CU-Rocketry/ground-station/README.md

# ground-station
Ground station for use with CUR SRAD flight computer with telemetry and user interface capabilities
