CU-Rocketry/ground-station/CUR_ground_station_25-26/CUR_ground_station_25-26.kicad_pcb

## KiCad design CUR_ground_station_25-26/CUR_ground_station_25-26.kicad_pcb (2026-04-16)

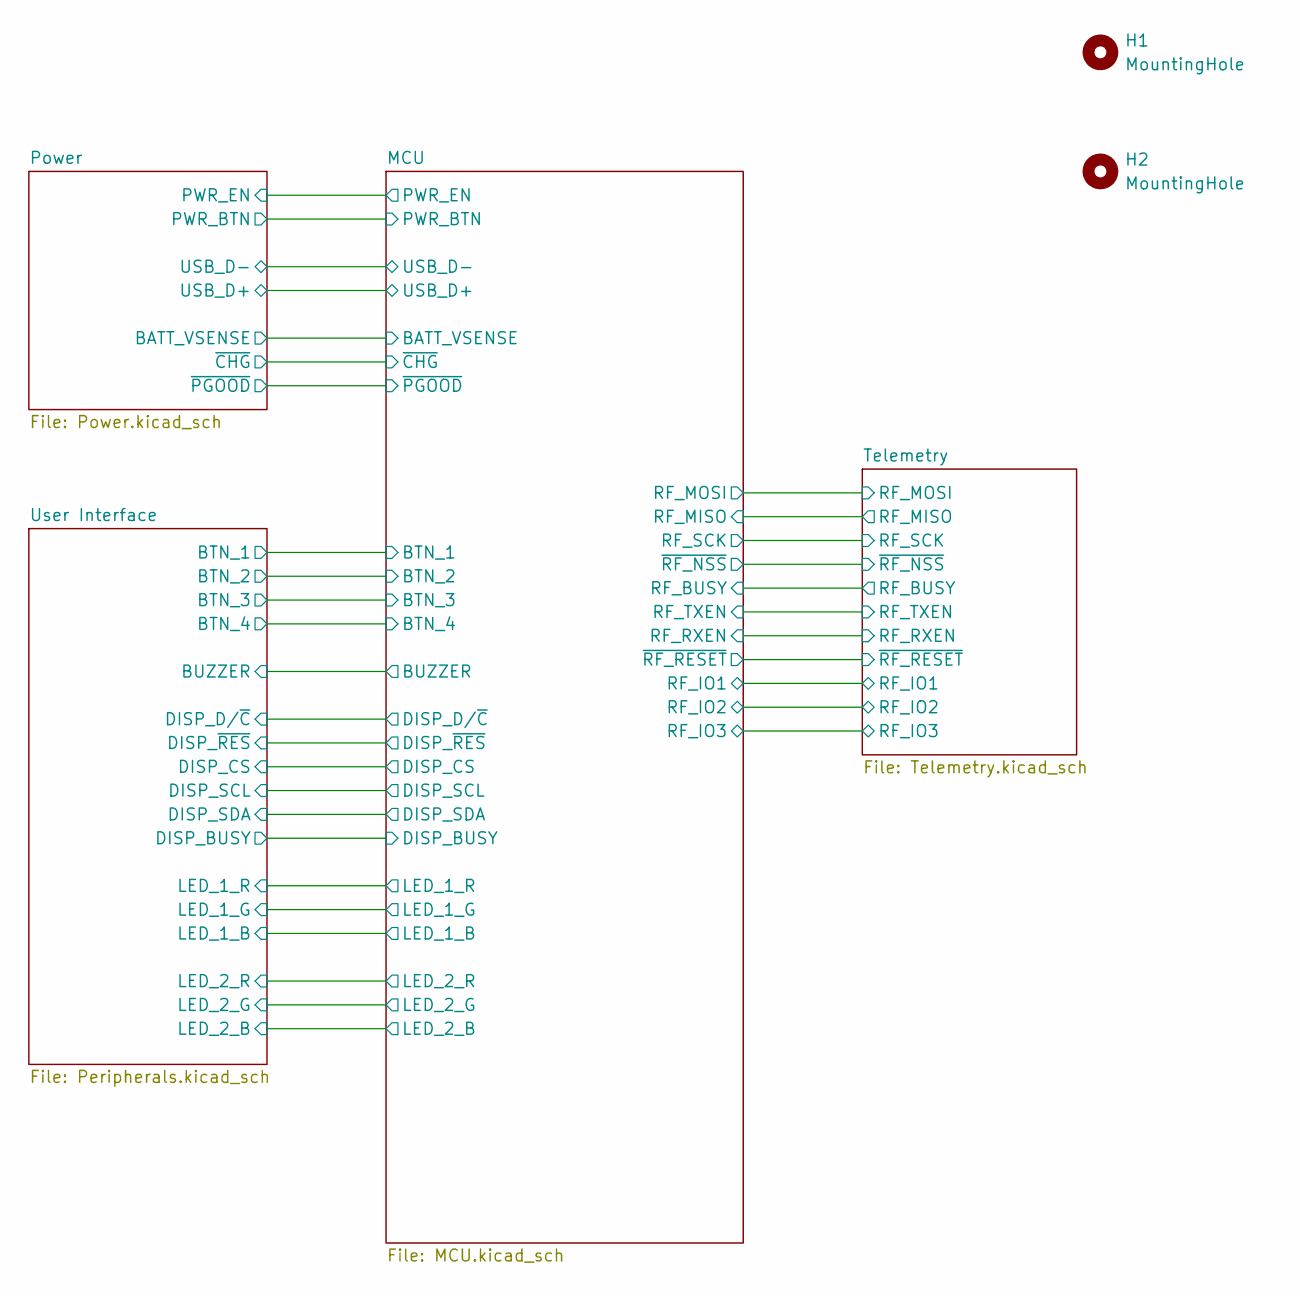
[picture p6: schematic CUR_ground_station_25-26.kicad_sch]

Parts:
H1, H2: MountingHole; MountingHole_3.2mm_M3

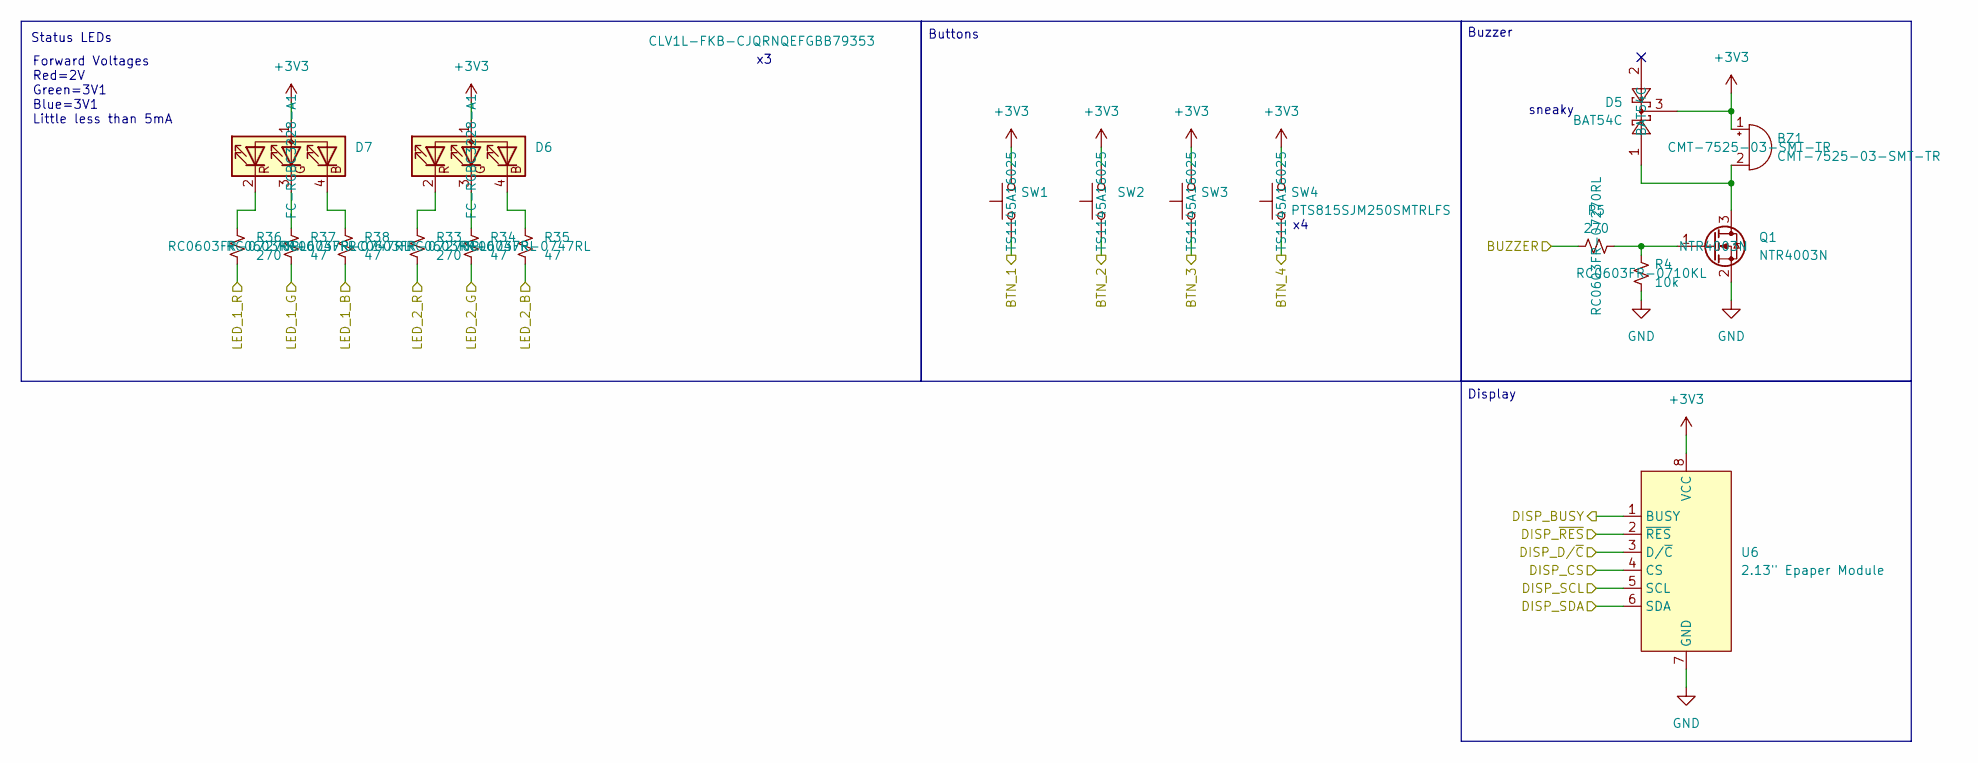
[picture p7: schematic Peripherals.kicad_sch]

Parts:
BZ1: CMT-7525-03-SMT-TR; XDCR_CMT-7525-03-SMT-TR; MPN CMT-7525-03-SMT-TR
D5: BAT54C; SOT-23; MPN BAT54C
D6, D7: CLV1L-FKB-CJQRNQEFGBB79353; LED_Cree-PLCC4_3.2x2.8mm_CCW; MPN FC-RGBC3228-A1
Q1: NTR4003N; SOT-23; MPN NTR4003N
R4: 10k; R_0603_1608Metric; MPN RC0603FR-0710KL
R5, R33, R36: 270; R_0603_1608Metric; MPN RC0603FR-07270RL
R34, R35, R37, R38: 47; R_0603_1608Metric; MPN RC0603FR-0747RL
SW1, SW2, SW3, SW4: PTS815SJM250SMTRLFS; SW_Push_PTS815_SJM_250_SMTR_LFS; MPN TS1145A16025
U6: 2.13" Epaper Module; WeAct-Studio-2.13-Epaper

Connections:
+3V3: BZ1.1 (+), D5.3, D6.1 (A), D7.1 (A), SW1.2, SW2.2, SW3.2, SW4.2, U6.8 (VCC); also elsewhere on the board
/MCU/BTN_1: SW1.1; also elsewhere on the board
/MCU/BTN_2: SW2.1; also elsewhere on the board
/MCU/BTN_3: SW3.1; also elsewhere on the board
/MCU/BTN_4: SW4.1; also elsewhere on the board
/MCU/BUZZER: R5.1; also elsewhere on the board
/MCU/DISP_BUSY: U6.1 (BUSY); also elsewhere on the board
/MCU/DISP_CS: U6.4 (CS); also elsewhere on the board
/MCU/DISP_D/~C: U6.3 (D/~C); also elsewhere on the board
/MCU/DISP_SCL: U6.5 (SCL); also elsewhere on the board
/MCU/DISP_SDA: U6.6 (SDA); also elsewhere on the board
/MCU/DISP_~RES: U6.2 (~RES); also elsewhere on the board
/MCU/LED_1_B: R38.2; also elsewhere on the board
/MCU/LED_1_G: R37.2; also elsewhere on the board
/MCU/LED_1_R: R36.2; also elsewhere on the board
/MCU/LED_2_B: R35.2; also elsewhere on the board
/MCU/LED_2_G: R34.2; also elsewhere on the board
/MCU/LED_2_R: R33.2; also elsewhere on the board
GND: Q1.2 (S), R4.2, U6.7 (GND); also elsewhere on the board
unnamed: BZ1.2 (-), D5.1, Q1.3 (D)
unnamed: D6.4 (BK), R35.1
unnamed: D6.3 (GK), R34.1
unnamed: D6.2 (RK), R33.1
unnamed: D7.4 (BK), R38.1
unnamed: D7.3 (GK), R37.1
unnamed: D7.2 (RK), R36.1
unnamed: Q1.1 (G), R4.1, R5.2

Notes on the sheet:
Forward Voltages Red=2V Green=3V1 Blue=3V1 Little less than 5mA
Buzzer
Buttons
sneaky
Display
Status LEDs

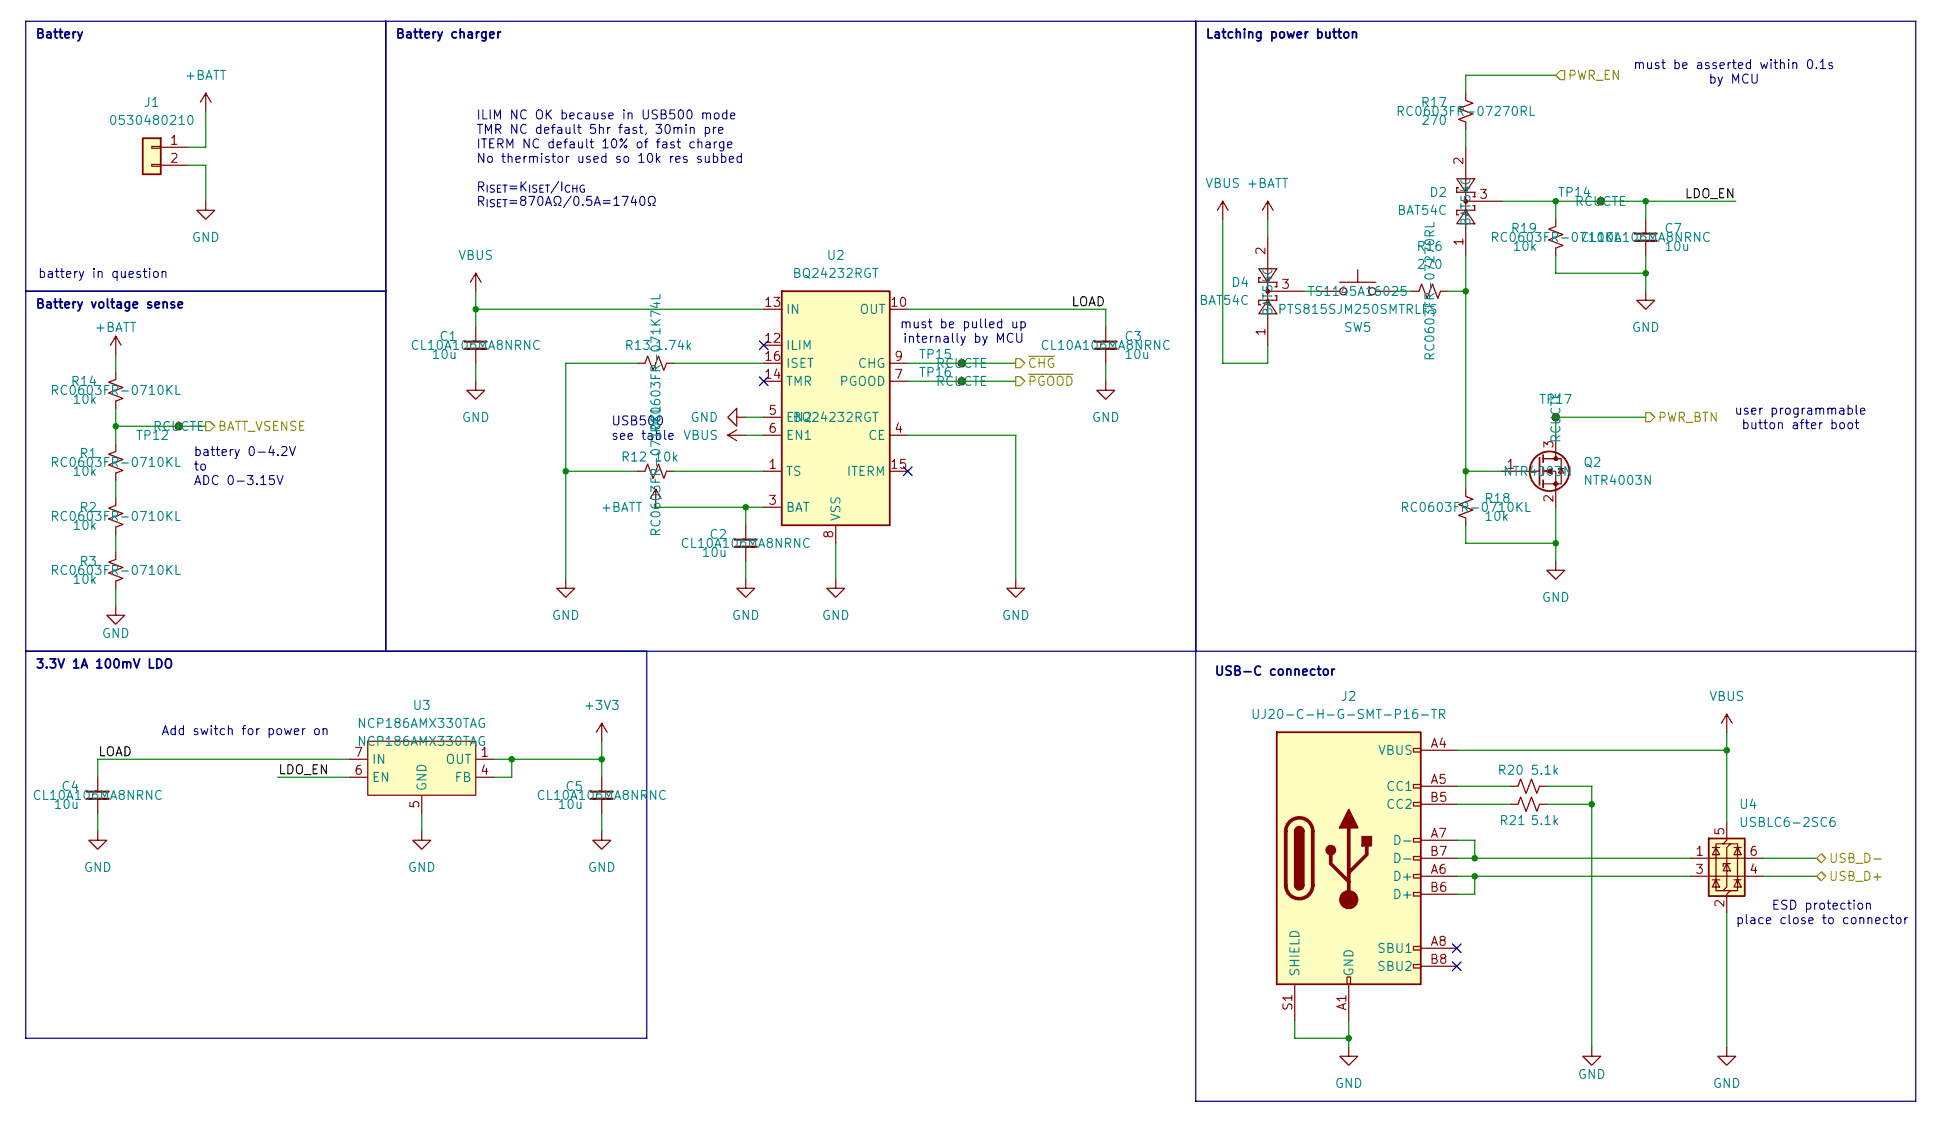
[picture p8: schematic Power.kicad_sch]

Parts:
C1, C2, C3, C4, C5, C7: 10u; C_0603_1608Metric; MPN CL10A106MA8NRNC
D2, D4: BAT54C; SOT-23; MPN BAT54C
J1: 0530480210; Molex_PicoBlade_53048-0210_1x02_P1.25mm_Horizontal; MPN 1.25-2AW
J2: UJ20-C-H-G-SMT-P16-TR; SAMESKY_UJ20-C-H-G-SMT-P16-TR; MPN UJ20-C-H-G-SMT-P16-TR
Q2: NTR4003N; SOT-23; MPN NTR4003N
R1, R2, R3, R12, R14, R18, R19: 10k; R_0603_1608Metric; MPN RC0603FR-0710KL
R13: 1.74k; R_0603_1608Metric; MPN RC0603FR-071K74L
R16, R17: 270; R_0603_1608Metric; MPN RC0603FR-07270RL
R20, R21: 5.1k; R_0603_1608Metric; MPN RC0603FR-075K1L
SW5: PTS815SJM250SMTRLFS; SW_Push_PTS815_SJM_250_SMTR_LFS; MPN TS1145A16025
TP12, TP14, TP15, TP16, TP17: TestPoint_Small; TestPoint_Chip_RCUCTE_0603; MPN RCUCTE
U2: BQ24232RGT; VQFN-16-1EP_3x3mm_P0.5mm_EP1.68x1.68mm; MPN BQ24232RGT
U3: NCP186AMX330TAG; NCP186_XDFN8_1.6x1.2mm_P0.4mm; MPN NCP186AMX330TAG
U4: USBLC6-2SC6; SOT-23-6; MPN USBLC6-2SC6

Connections:
+3V3: C5.1, U3.1 (OUT), U3.2 (OUT), U3.4 (FB); also elsewhere on the board
+BATT: C2.1, D4.2, J1.1, R14.1, U2.2 (BAT), U2.3 (BAT)
/MCU/BATT_VSENSE: R1.1, R14.2, TP12.1; also elsewhere on the board
/MCU/PWR_BTN: Q2.3 (D), TP17.1; also elsewhere on the board
/MCU/PWR_EN: R17.1; also elsewhere on the board
/MCU/USB_D+: U4.4 (I/O2); also elsewhere on the board
/MCU/USB_D-: U4.6 (I/O1); also elsewhere on the board
/MCU/~CHG: TP15.1, U2.9 (CHG); also elsewhere on the board
/MCU/~PGOOD: TP16.1, U2.7 (PGOOD); also elsewhere on the board
/Power/LDO_EN: C7.1, D2.3, R19.1, TP14.1, U3.6 (EN)
GND: C1.2, C2.2, C3.2, C4.2, C5.2, C7.2, J1.2, J2.A1 (GND), J2.A12 (GND), J2.B1 (GND), J2.B12 (GND), J2.S1 (SHIELD), Q2.2 (S), R3.2, R12.1, R13.1, R18.2, R19.2, R20.2, R21.2, U2.4 (CE), U2.5 (EN2), U2.8 (VSS), U2.17 (VSS), U3.3 (N/C), U3.5 (GND), U3.9 (EPAD), U4.2 (GND); also elsewhere on the board
IN: C3.1, C4.1, U2.10 (OUT), U2.11 (OUT), U3.7 (IN), U3.8 (IN)
unnamed: D2.2, R17.2
unnamed: D4.3, SW5.1
unnamed: J2.A5 (CC1), R20.1
unnamed: J2.B5 (CC2), R21.1
unnamed: J2.A6 (D+), J2.B6 (D+), U4.3 (I/O2)
unnamed: J2.A7 (D-), J2.B7 (D-), U4.1 (I/O1)
unnamed: D2.1, Q2.1 (G), R16.2, R18.1
unnamed: R1.2, R2.1
unnamed: R2.2, R3.1
unnamed: R16.1, SW5.2
unnamed: R13.2, U2.16 (ISET)
unnamed: R12.2, U2.1 (TS)
VBUS: C1.1, D4.1, J2.A4 (VBUS), J2.A9 (VBUS), J2.B4 (VBUS), J2.B9 (VBUS), U2.6 (EN1), U2.13 (IN), U4.5 (VBUS)

Notes on the sheet:
R_{ISET}=K_{ISET}/I_{CHG} R_{ISET}=870AΩ/0.5A=1740Ω
must be asserted within 0.1s by MCU
3.3V 1A 100mV LDO
Battery voltage sense
USB-C connector
ILIM NC OK because in USB500 mode TMR NC default 5hr fast, 30min pre ITERM NC default 10% of fast charge No thermistor used so 10k res subbed
Battery
USB500 see table
Latching power button
Add switch for power on
battery 0-4.2V to ADC 0-3.15V
Battery charger
ESD protection place close to connector
must be pulled up internally by MCU
user programmable button after boot
battery in question

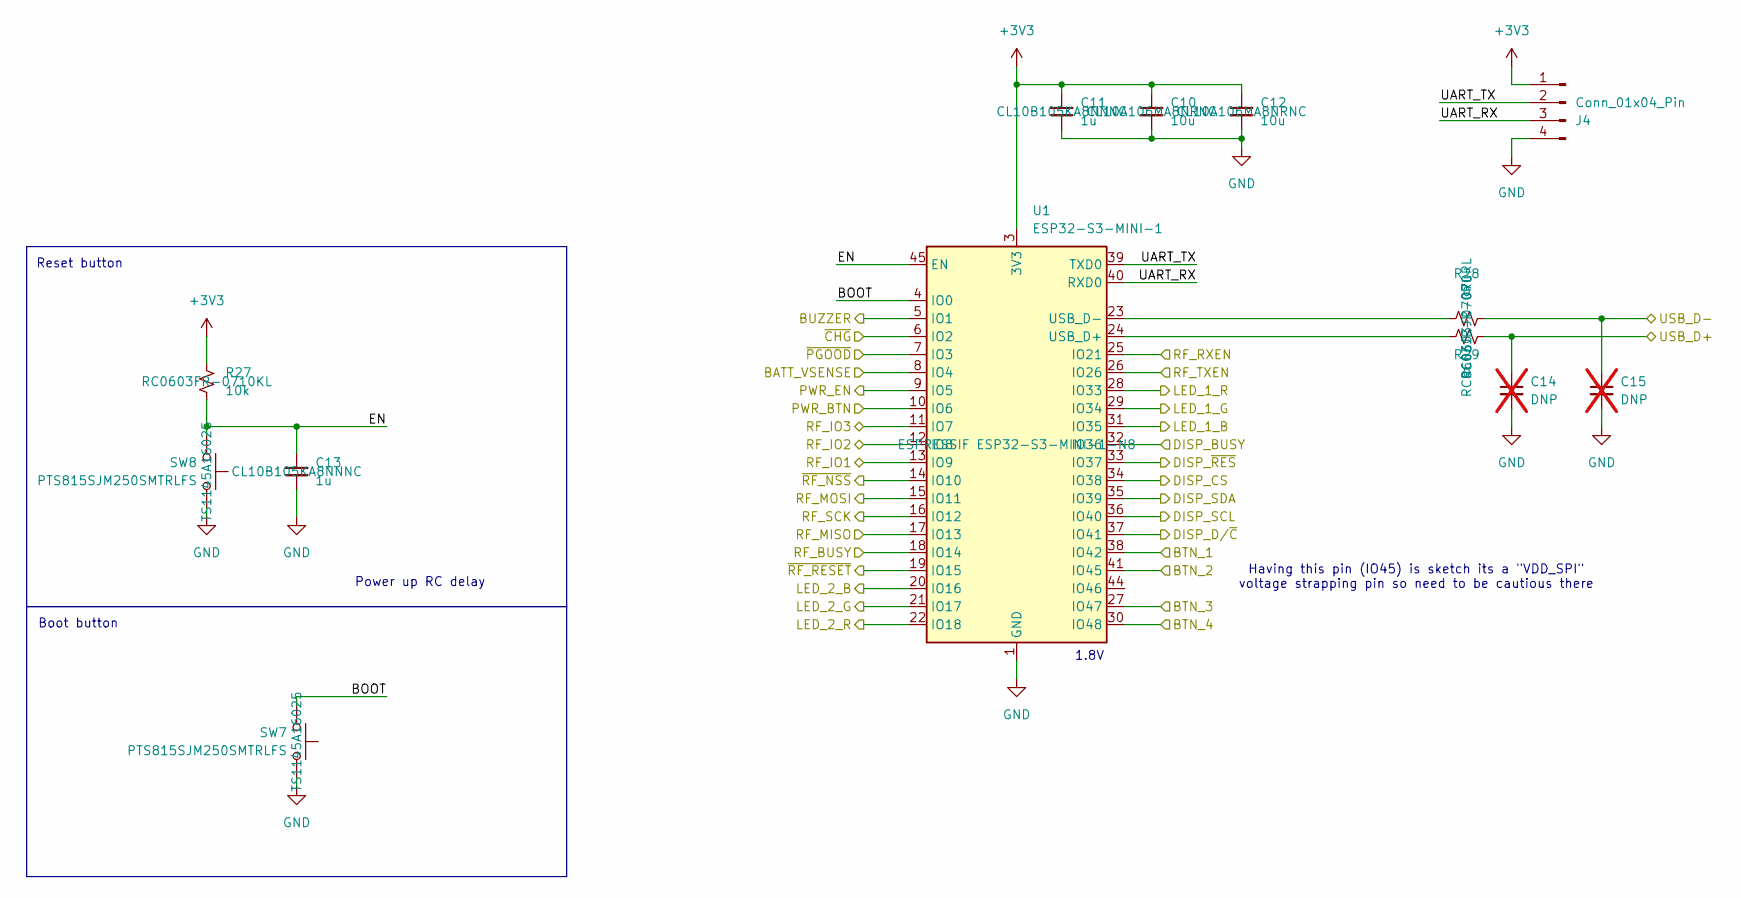
[picture p9: schematic MCU.kicad_sch]

Parts:
C10, C12: 10u; C_0603_1608Metric; MPN CL10A106MA8NRNC
C11, C13: 1u; C_0603_1608Metric; MPN CL10B105KA8NNNC
C14, C15: DNP; C_0603_1608Metric; not fitted
J4: Conn_01x04_Pin; PinHeader_1x04_P2.54mm_Vertical
R27: 10k; R_0603_1608Metric; MPN RC0603FR-0710KL
R28, R29: 0; R_0603_1608Metric; MPN RC0603JR-070RL
SW7, SW8: PTS815SJM250SMTRLFS; SW_Push_PTS815_SJM_250_SMTR_LFS; MPN TS1145A16025
U1: ESP32-S3-MINI-1; ESP32-S2-MINI-1; MPN ESPRESSIF ESP32-S3-MINI-1-N8

Connections:
+3V3: C10.1, C11.1, C12.1, J4.1, R27.1, U1.3 (3V3); also elsewhere on the board
/MCU/BATT_VSENSE: U1.8 (IO4); also elsewhere on the board
/MCU/BOOT: SW7.2, U1.4 (IO0)
/MCU/BTN_1: U1.38 (IO42); also elsewhere on the board
/MCU/BTN_2: U1.41 (IO45); also elsewhere on the board
/MCU/BTN_3: U1.27 (IO47); also elsewhere on the board
/MCU/BTN_4: U1.30 (IO48); also elsewhere on the board
/MCU/BUZZER: U1.5 (IO1); also elsewhere on the board
/MCU/DISP_BUSY: U1.32 (IO36); also elsewhere on the board
/MCU/DISP_CS: U1.34 (IO38); also elsewhere on the board
/MCU/DISP_D/~C: U1.37 (IO41); also elsewhere on the board
/MCU/DISP_SCL: U1.36 (IO40); also elsewhere on the board
/MCU/DISP_SDA: U1.35 (IO39); also elsewhere on the board
/MCU/DISP_~RES: U1.33 (IO37); also elsewhere on the board
/MCU/EN: C13.1, R27.2, SW8.2, U1.45 (EN)
/MCU/LED_1_B: U1.31 (IO35); also elsewhere on the board
/MCU/LED_1_G: U1.29 (IO34); also elsewhere on the board
/MCU/LED_1_R: U1.28 (IO33); also elsewhere on the board
/MCU/LED_2_B: U1.20 (IO16); also elsewhere on the board
/MCU/LED_2_G: U1.21 (IO17); also elsewhere on the board
/MCU/LED_2_R: U1.22 (IO18); also elsewhere on the board
/MCU/PWR_BTN: U1.10 (IO6); also elsewhere on the board
/MCU/PWR_EN: U1.9 (IO5); also elsewhere on the board
/MCU/RF_BUSY: U1.18 (IO14); also elsewhere on the board
/MCU/RF_IO1: U1.13 (IO9); also elsewhere on the board
/MCU/RF_IO2: U1.12 (IO8); also elsewhere on the board
/MCU/RF_IO3: U1.11 (IO7); also elsewhere on the board
/MCU/RF_MISO: U1.17 (IO13); also elsewhere on the board
/MCU/RF_MOSI: U1.15 (IO11); also elsewhere on the board
/MCU/RF_RXEN: U1.25 (IO21); also elsewhere on the board
/MCU/RF_SCK: U1.16 (IO12); also elsewhere on the board
/MCU/RF_TXEN: U1.26 (IO26); also elsewhere on the board
/MCU/UART_RX: J4.3, U1.40 (RXD0)
/MCU/UART_TX: J4.2, U1.39 (TXD0)
/MCU/USB_D+: C14.1, R29.2; also elsewhere on the board
/MCU/USB_D-: C15.1, R28.2; also elsewhere on the board
/MCU/~CHG: U1.6 (IO2); also elsewhere on the board
/MCU/~PGOOD: U1.7 (IO3); also elsewhere on the board
/MCU/~RF_NSS: U1.14 (IO10); also elsewhere on the board
/MCU/~RF_RESET: U1.19 (IO15); also elsewhere on the board
GND: C10.2, C11.2, C12.2, C13.2, C14.2, C15.2, J4.4, SW7.1, SW8.1, U1.1 (GND), U1.2 (GND), U1.42 (GND), U1.43 (GND), U1.46 (GND), U1.47 (GND), U1.48 (GND), U1.49 (GND), U1.50 (GND), U1.51 (GND), U1.52 (GND), U1.53 (GND), U1.54 (GND), U1.55 (GND), U1.56 (GND), U1.57 (GND), U1.58 (GND), U1.59 (GND), U1.60 (GND), U1.61 (GND), U1.62 (GND), U1.63 (GND), U1.64 (GND), U1.65 (GND); also elsewhere on the board
unnamed: R29.1, U1.24 (USB_D+)
unnamed: R28.1, U1.23 (USB_D-)

Notes on the sheet:
Boot button
1.8V
Power up RC delay
Reset button
Having this pin (IO45) is sketch its a "VDD_SPI" voltage strapping pin so need to be cautious there

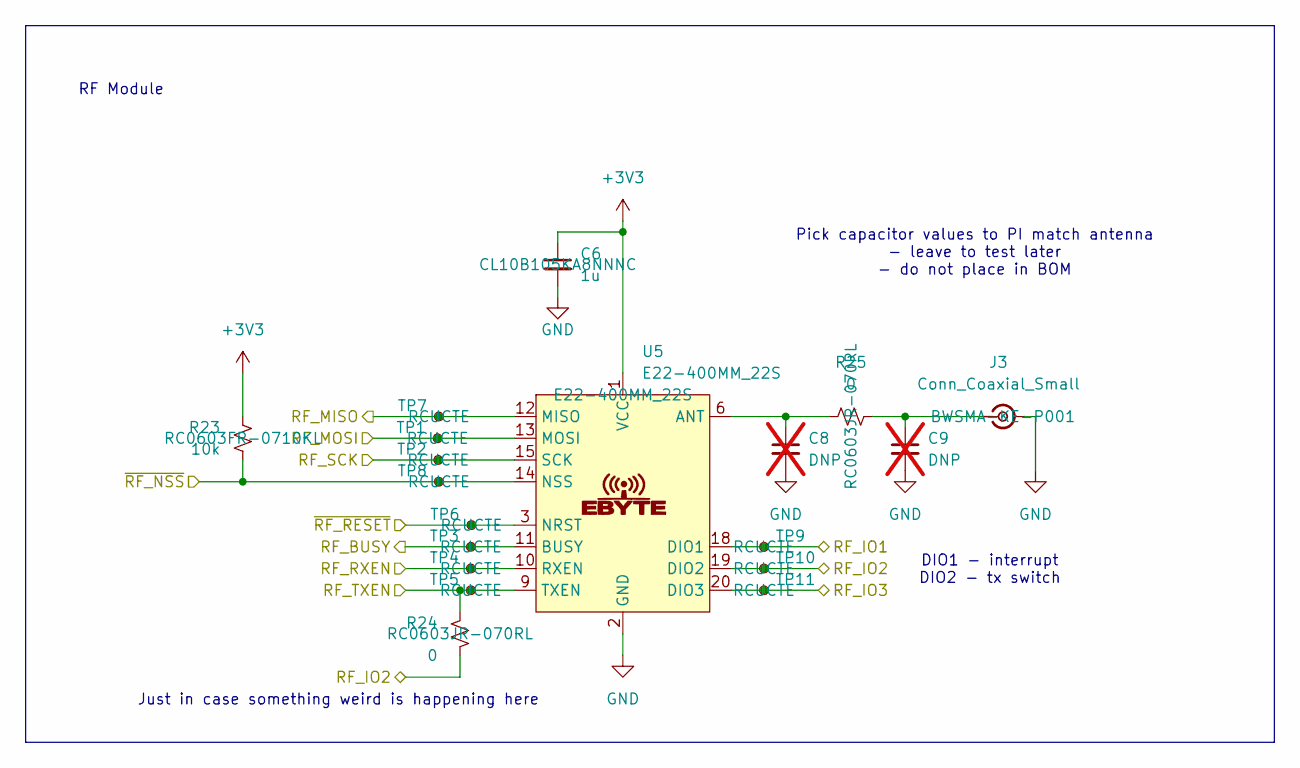
[picture p10: schematic Telemetry.kicad_sch]

Parts:
C6: 1u; C_0603_1608Metric; MPN CL10B105KA8NNNC
C8, C9: DNP; C_0603_1608Metric; not fitted
J3: Conn_Coaxial_Small; Conn_Coaxial_RFSOLUTIONS_CON-SMA-EDGE-S; MPN BWSMA-KE-P001
R23: 10k; R_0603_1608Metric; MPN RC0603FR-0710KL
R24, R25: 0; R_0603_1608Metric; MPN RC0603JR-070RL
TP1, TP2, TP3, TP4, TP5, TP6, TP7, TP8, TP9, TP10, TP11: TestPoint_Small; TestPoint_Chip_RCUCTE_0603; MPN RCUCTE
U5: E22-400MM_22S; EBYTE_LoRA_E22-400MM22S; MPN E22-400MM_22S

Connections:
+3V3: C6.1, R23.1, U5.1 (VCC); also elsewhere on the board
/MCU/RF_BUSY: TP3.1, U5.11 (BUSY); also elsewhere on the board
/MCU/RF_IO1: TP9.1, U5.18 (DIO1); also elsewhere on the board
/MCU/RF_IO2: R24.2, TP10.1, U5.19 (DIO2); also elsewhere on the board
/MCU/RF_IO3: TP11.1, U5.20 (DIO3); also elsewhere on the board
/MCU/RF_MISO: TP7.1, U5.12 (MISO); also elsewhere on the board
/MCU/RF_MOSI: TP1.1, U5.13 (MOSI); also elsewhere on the board
/MCU/RF_RXEN: TP4.1, U5.10 (RXEN); also elsewhere on the board
/MCU/RF_SCK: TP2.1, U5.15 (SCK); also elsewhere on the board
/MCU/RF_TXEN: R24.1, TP5.1, U5.9 (TXEN); also elsewhere on the board
/MCU/~RF_NSS: R23.2, TP8.1, U5.14 (NSS); also elsewhere on the board
/MCU/~RF_RESET: TP6.1, U5.3 (NRST); also elsewhere on the board
GND: C6.2, C8.2, C9.2, J3.2 (Ext), U5.2 (GND), U5.7 (GND), U5.16 (GND); also elsewhere on the board
unnamed: C9.1, J3.1 (In), R25.1
unnamed: C8.1, R25.2, U5.6 (ANT)

Notes on the sheet:
Pick capacitor values to PI match antenna - leave to test later - do not place in BOM
DIO1 - interrupt DIO2 - tx switch
RF Module
Just in case something weird is happening here

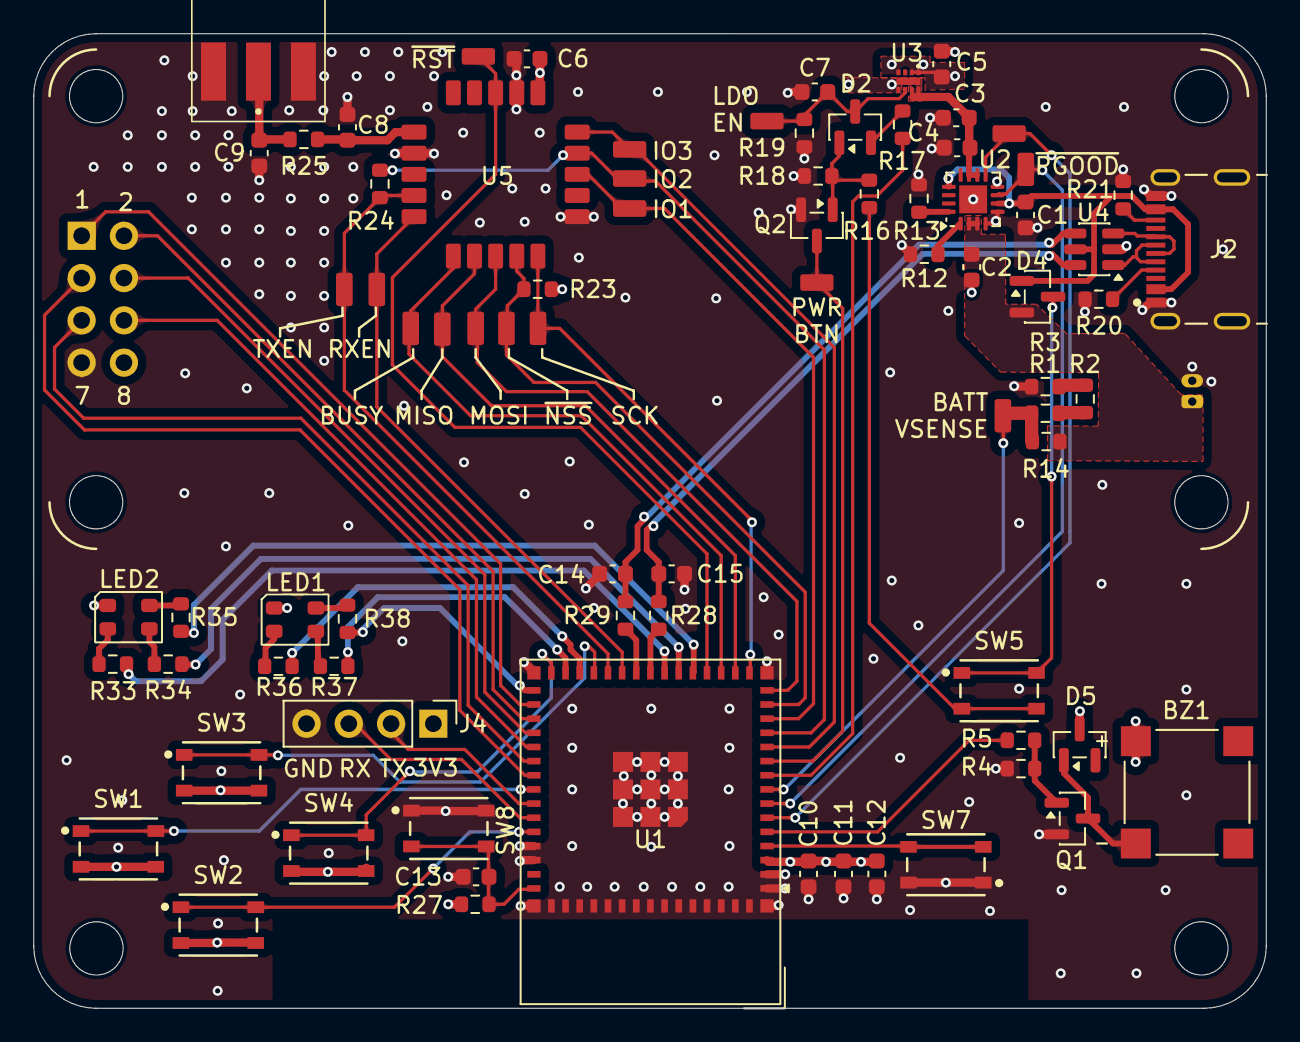
[picture p11: board CUR_ground_station_25-26.kicad_pcb from above]

Board: 4 copper layers, 74.0 x 58.5 mm, 84 parts (1 on the bottom side), 69 nets.
