CU-Rocketry/ground-station/(commit log)

2026-02-25 created kicad project file
    [CUR_ground_station_25-26.kicad_pcb, CUR_ground_station_25-26.kicad_sch]
2026-02-25 added sheets and mcu
    [CUR_ground_station_25-26.kicad_sch, MCU.kicad_sch, Peripherals.kicad_sch, Power.kicad_sch, Telemetry.kicad_sch]
2026-02-25 Add kicad-library submodule
2026-02-25 added power stuff
    [Power.kicad_sch]
2026-02-26 added user stuff
    [CUR_ground_station_25-26.kicad_sch, MCU.kicad_sch, Peripherals.kicad_sch]
2026-02-26 Add footprints and symbols for power
2026-02-26 Implement battery management, soft power on, and LDO
    [Power.kicad_sch]
2026-03-04 added buncha stuff from flight computer
    [Peripherals.kicad_sch, Power.kicad_sch, Telemetry.kicad_sch]
2026-03-30 DNP the tuning capacitors on the RF trace
    [Telemetry.kicad_sch]
2026-03-30 Connect 3.3V and GND to MCU
    [MCU.kicad_sch]
2026-03-30 Correct soft power off circuit to support USB and battery
    [Power.kicad_sch]
2026-03-30 Add epaper
    [Peripherals.kicad_sch]
2026-03-30 Cleanup UI sheet
    [Peripherals.kicad_sch]
2026-03-30 Cleanup peripherals again
    [Peripherals.kicad_sch]
2026-03-30 Add testpoints to power
    [Power.kicad_sch]
2026-03-30 Add some required MCU components
    [CUR_ground_station_25-26.kicad_sch, MCU.kicad_sch, Telemetry.kicad_sch]
2026-03-30 Sync sheet pins
    [CUR_ground_station_25-26.kicad_sch, MCU.kicad_sch]
2026-03-31 Started placing pins on MCU
    [CUR_ground_station_25-26.kicad_pcb, MCU.kicad_sch, Power.kicad_sch]
2026-03-31 Change MCU, hookup more pins
    [MCU.kicad_sch, Peripherals.kicad_sch]
2026-04-01 updating footprints
    [MCU.kicad_sch, Peripherals.kicad_sch, Power.kicad_sch]
2026-04-01 added more footprints
    [MCU.kicad_sch, Peripherals.kicad_sch, Telemetry.kicad_sch]
2026-04-01 started layout-ing
    [CUR_ground_station_25-26.kicad_pcb, Peripherals.kicad_sch, Power.kicad_sch]
2026-04-01 preliminary layout
    [CUR_ground_station_25-26.kicad_pcb]
2026-04-01 Power layout
    [CUR_ground_station_25-26.kicad_pcb]
2026-04-01 added power switch
    [Power.kicad_sch]
2026-04-01 ignore the fact I added a switch
    [Power.kicad_sch]
2026-04-01 started brief power routing
    [CUR_ground_station_25-26.kicad_pcb]
2026-04-03 found decent power layout
    [CUR_ground_station_25-26.kicad_pcb]
2026-04-03 more power layout ing
    [CUR_ground_station_25-26.kicad_pcb]
2026-04-06 BOM optimization
    [MCU.kicad_sch, Peripherals.kicad_sch, Power.kicad_sch, Telemetry.kicad_sch]
2026-04-06 Increase RC delay on power button
    [Power.kicad_sch]
2026-04-06 Fix library issues in board update
    [Telemetry.kicad_sch]
2026-04-06 Update board shape, display, and USB C placement
    [CUR_ground_station_25-26.kicad_pcb]
2026-04-06 Fix USB capacitors
    [CUR_ground_station_25-26.kicad_pcb, MCU.kicad_sch]
2026-04-06 Add mounting holes
    [CUR_ground_station_25-26.kicad_pcb, CUR_ground_station_25-26.kicad_sch]
2026-04-06 switched battery connector, put mounting holes in place
    [CUR_ground_station_25-26.kicad_pcb, MCU.kicad_sch, Peripherals.kicad_sch, Power.kicad_sch]
2026-04-07 Started routing power
    [CUR_ground_station_25-26.kicad_pcb]
2026-04-07 routing power section
    [CUR_ground_station_25-26.kicad_pcb, MCU.kicad_sch]
2026-04-07 preliminary 3v3 rail routed
    routed on top layer. Its...interesting...
    [CUR_ground_station_25-26.kicad_pcb, Peripherals.kicad_sch]
2026-04-08 changed to four layer board
    [CUR_ground_station_25-26.kicad_pcb]
2026-04-08 signal routing
    [CUR_ground_station_25-26.kicad_pcb, MCU.kicad_sch]
2026-04-08 routing, ddrc addressed
    [CUR_ground_station_25-26.kicad_pcb]
2026-04-08 vias place, some labeling
    [CUR_ground_station_25-26.kicad_pcb]
2026-04-08 labing, adding gnd vias, other cleanup
    [CUR_ground_station_25-26.kicad_pcb, Power.kicad_sch]
2026-04-08 routing progress
    [CUR_ground_station_25-26.kicad_pcb]
2026-04-10 made gerbers, etc.
    [CUR_ground_station_25-26-B_Cu.gbr, CUR_ground_station_25-26-B_Mask.gbr, CUR_ground_station_25-26-B_Paste.gbr, CUR_ground_station_25-26-B_Silkscreen.gbr, CUR_ground_station_25-26-Edge_Cuts.gbr, CUR_ground_station_25-26-F_Mask.gbr, CUR_ground_station_25-26-F_Paste.gbr, CUR_ground_station_25-26-F_Silkscreen.gbr]
2026-04-10 Generate final gerbers
    [CUR_ground_station_25-26-B_Cu.gbr, CUR_ground_station_25-26-B_Mask.gbr, CUR_ground_station_25-26-B_Paste.gbr, CUR_ground_station_25-26-B_Silkscreen.gbr, CUR_ground_station_25-26-Edge_Cuts.gbr, CUR_ground_station_25-26-F_Mask.gbr, CUR_ground_station_25-26-F_Paste.gbr, CUR_ground_station_25-26-F_Silkscreen.gbr]
2026-04-10 gerber files zipped
    [CUR_ground_station_25-26-B_Cu.gbr, CUR_ground_station_25-26-B_Mask.gbr, CUR_ground_station_25-26-B_Paste.gbr, CUR_ground_station_25-26-B_Silkscreen.gbr, CUR_ground_station_25-26-Edge_Cuts.gbr, CUR_ground_station_25-26-F_Mask.gbr, CUR_ground_station_25-26-F_Paste.gbr, CUR_ground_station_25-26-F_Silkscreen.gbr]
2026-04-10 change gerbers
    [CUR_ground_station_25-26-B_Cu.gbr, CUR_ground_station_25-26-B_Mask.gbr, CUR_ground_station_25-26-B_Paste.gbr, CUR_ground_station_25-26-B_Silkscreen.gbr, CUR_ground_station_25-26-Edge_Cuts.gbr, CUR_ground_station_25-26-F_Cu.gbr, CUR_ground_station_25-26-F_Mask.gbr, CUR_ground_station_25-26-F_Paste.gbr]
2026-04-10 gerbers again
    [CUR_ground_station_25-26-B_Cu.gbr, CUR_ground_station_25-26-B_Mask.gbr, CUR_ground_station_25-26-B_Paste.gbr, CUR_ground_station_25-26-B_Silkscreen.gbr, CUR_ground_station_25-26-Edge_Cuts.gbr, CUR_ground_station_25-26-F_Cu.gbr, CUR_ground_station_25-26-F_Mask.gbr, CUR_ground_station_25-26-F_Paste.gbr]
2026-04-10 the RIGHT gerbers
    [CUR_ground_station_25-26-B_Cu.gbr, CUR_ground_station_25-26-B_Mask.gbr, CUR_ground_station_25-26-B_Paste.gbr, CUR_ground_station_25-26-B_Silkscreen.gbr, CUR_ground_station_25-26-Edge_Cuts.gbr, CUR_ground_station_25-26-F_Cu.gbr, CUR_ground_station_25-26-F_Mask.gbr, CUR_ground_station_25-26-F_Paste.gbr]
2026-04-10 ger b e r
    [CUR_ground_station_25-26-B_Cu.gbr, CUR_ground_station_25-26-B_Mask.gbr, CUR_ground_station_25-26-B_Paste.gbr, CUR_ground_station_25-26-B_Silkscreen.gbr, CUR_ground_station_25-26-Edge_Cuts.gbr, CUR_ground_station_25-26-F_Cu.gbr, CUR_ground_station_25-26-F_Mask.gbr, CUR_ground_station_25-26-F_Paste.gbr]
2026-04-10 Update gerbers after rotating battery connector
    [CUR_ground_station_25-26-B_Cu.gbr, CUR_ground_station_25-26-B_Mask.gbr, CUR_ground_station_25-26-B_Paste.gbr, CUR_ground_station_25-26-B_Silkscreen.gbr, CUR_ground_station_25-26-Edge_Cuts.gbr, CUR_ground_station_25-26-F_Cu.gbr, CUR_ground_station_25-26-F_Mask.gbr, CUR_ground_station_25-26-F_Paste.gbr]
2026-04-10 Update kicad-library
2026-04-10 Update LDO and battery charger footprints
    [Power.kicad_sch]
2026-04-10 Update gerbers
    [CUR_ground_station_25-26-B_Cu.gbr, CUR_ground_station_25-26-B_Mask.gbr, CUR_ground_station_25-26-B_Paste.gbr, CUR_ground_station_25-26-B_Silkscreen.gbr, CUR_ground_station_25-26-Edge_Cuts.gbr, CUR_ground_station_25-26-F_Cu.gbr, CUR_ground_station_25-26-F_Mask.gbr, CUR_ground_station_25-26-F_Paste.gbr]
2026-04-10 Update PCB (BAD we have to redo the TP labels)
    [CUR_ground_station_25-26.kicad_pcb]
2026-04-10 Find MPNs again
    [MCU.kicad_sch, Peripherals.kicad_sch, Power.kicad_sch, Telemetry.kicad_sch]
2026-04-10 Fix labels
    [CUR_ground_station_25-26.kicad_pcb]
2026-04-10 New gerbers
    [CUR_ground_station_25-26-B_Cu.gbr, CUR_ground_station_25-26-B_Mask.gbr, CUR_ground_station_25-26-B_Paste.gbr, CUR_ground_station_25-26-B_Silkscreen.gbr, CUR_ground_station_25-26-Edge_Cuts.gbr, CUR_ground_station_25-26-F_Cu.gbr, CUR_ground_station_25-26-F_Mask.gbr, CUR_ground_station_25-26-F_Paste.gbr]
2026-04-16 New gerbers for nextpcb
    [CUR_ground_station_25-26-B_Cu.gbl, CUR_ground_station_25-26-B_Mask.gbs, CUR_ground_station_25-26-B_Paste.gbp, CUR_ground_station_25-26-B_Silkscreen.gbo, CUR_ground_station_25-26-Edge_Cuts.gm1, CUR_ground_station_25-26-F_Cu.gtl, CUR_ground_station_25-26-F_Mask.gts, CUR_ground_station_25-26-F_Paste.gtp]
